PowerBroker2/5_Hole_Probe_PRoject/Calibration_Files/photos/IMG_2492.JPG

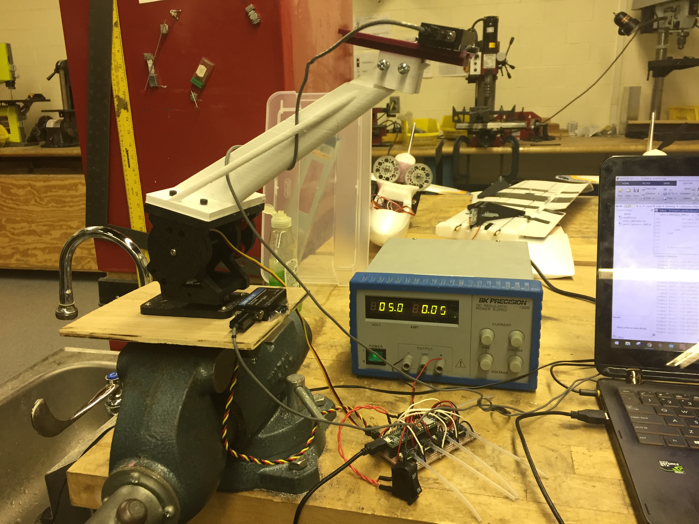
Calibration_Files/photos/IMG_2492.JPG
