PowerBroker2/5_Hole_Probe_PRoject/README.md

# 5 Hole Probe Project
Data acquisition unit for an experimental 5 hole pitot tube.
