PowerBroker2/5_Hole_Probe_PRoject/Teensy_Datalogger_Prototype/pjrc_teensy36_detail.jpg

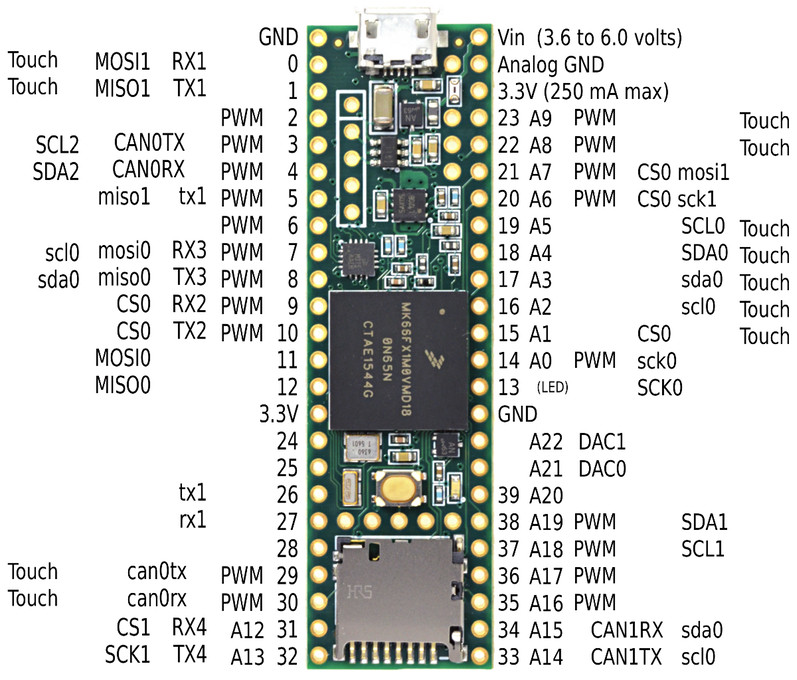
Teensy_Datalogger_Prototype/pjrc_teensy36_detail.jpg
