PowerBroker2/5_Hole_Probe_PRoject/Teensy_Datalogger_Prototype/Pressure_Sensor_Test_Graph.pdf

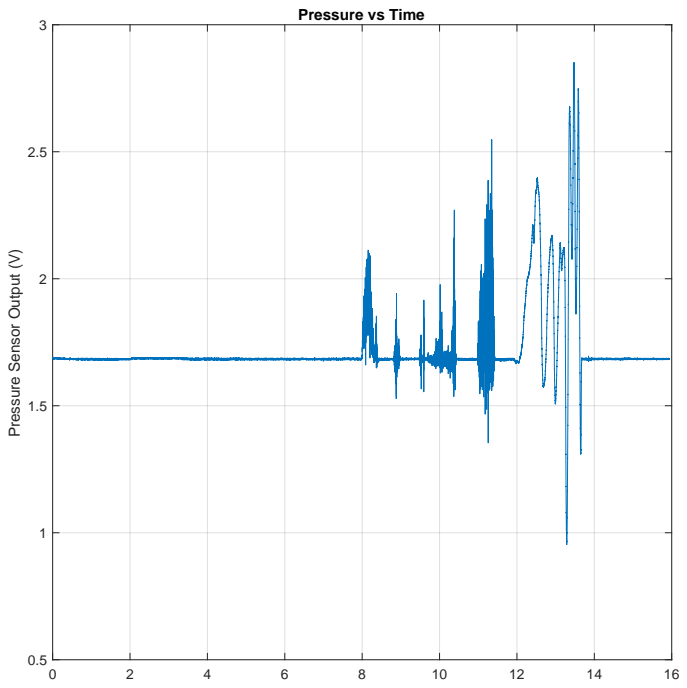
[picture p8: page 1]

Pressure vs Time

Pressure Sensor Output (V)
