PowerBroker2/5_Hole_Probe_PRoject/Teensy_Datalogger_Prototype/Eagle_Schematic/5HP_Datalogger/5HP_Datalogger.sch

## EAGLE design Teensy_Datalogger_Prototype/Eagle_Schematic/5HP_Datalogger/5HP_Datalogger.sch (2019-06-13)

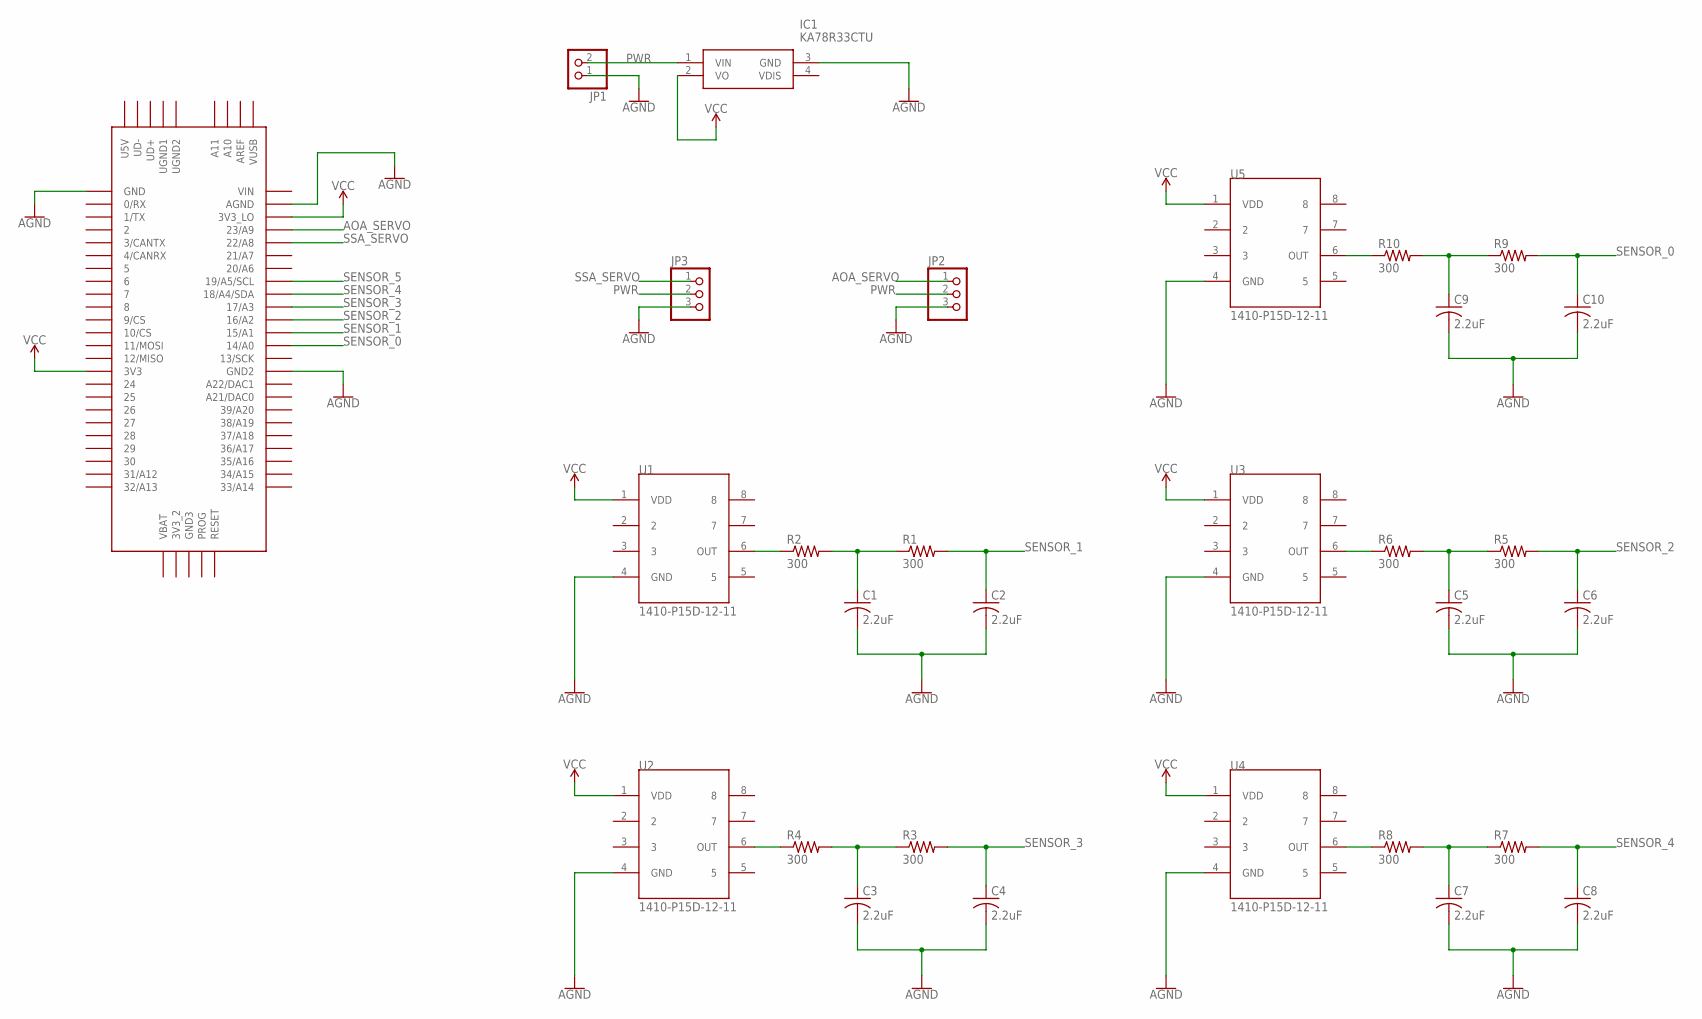
[picture p9: schematic 5HP_Datalogger.sch]

Parts:
C1, C2, C3, C4, C5, C6, C7, C8, C9, C10: 2.2uF; C075-032X103
IC1: KA78R33CTU; TO254P470X1000X1960-4P
JP1: PINHD-1X2; 1X02
JP2, JP3: PINHD-1X3; 1X03
R1, R2, R3, R4, R5, R6, R7, R8, R9, R10: 300; 0207/10
U1, U2, U3, U4, U5: 1410-P15D-12-11
U$2: TEENSY_3.5/3.6

Connections:
AGND: C1.2, C2.2, C3.2, C4.2, C5.2, C6.2, C7.2, C8.2, C9.2, C10.2, IC1.3 (GND), JP1.1, JP2.3, JP3.3, U1.4 (GND), U2.4 (GND), U3.4 (GND), U4.4 (GND), U5.4 (GND), U$2.AGND, U$2.GND, U$2.GND2
AOA_SERVO: JP2.1, U$2.23/A9
unnamed: R2.1, U1.6 (OUT)
unnamed: C1.1, R1.1, R2.2
unnamed: R4.1, U2.6 (OUT)
unnamed: C3.1, R3.1, R4.2
unnamed: R6.1, U3.6 (OUT)
unnamed: C5.1, R5.1, R6.2
unnamed: R8.1, U4.6 (OUT)
unnamed: C7.1, R7.1, R8.2
unnamed: R10.1, U5.6 (OUT)
unnamed: C9.1, R9.1, R10.2
PWR: IC1.1 (VIN), JP1.2, JP2.2, JP3.2
SENSOR_0: C10.1, R9.2, U$2.14/A0
SENSOR_1: C2.1, R1.2, U$2.15/A1
SENSOR_2: C6.1, R5.2, U$2.16/A2
SENSOR_3: C4.1, R3.2, U$2.17/A3
SENSOR_4: C8.1, R7.2, U$2.18/A4/SDA
SENSOR_5: U$2.19/A5/SCL
SSA_SERVO: JP3.1, U$2.22/A8
VCC: IC1.2 (VO), U1.1 (VDD), U2.1 (VDD), U3.1 (VDD), U4.1 (VDD), U5.1 (VDD), U$2.3V3, U$2.3V3_LO
