PowerBroker2/5_Hole_Probe_PRoject/Calibration_Files/before_wind_tunnel_servo_calibration_AOA_15mps.txt

-3.201732
0.748843
0
-3.215551
0.725717
0
-3.228972
0.724204
0
-3.251781
0.724204
0
-3.256113
0.713502
0
-3.248900
0.713502
0
-3.221786
0.721592
0
-3.227844
0.721592
0
-3.251930
0.750256
0
-3.228832
0.750256
0
-3.242966
0.769452
0
-3.221094
0.769452
0
-3.230644
0.737074
0
-3.229918
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
