PowerBroker2/5_Hole_Probe_PRoject/Calibration_Files/before_wind_tunnel_servo_calibration_AOA_5mps.txt

-4.615601
0.366127
0
-4.614052
0.364701
0
-4.617850
0.364701
0
-4.623018
0.367634
0
-4.626394
0.367634
0
-4.624328
0.371338
0
-4.622633
0.371338
0
-4.630738
0.371309
0
-4.631361
0.371309
0
-4.628824
0.373495
0
-4.631854
0.373495
0
-4.639075
0.381193
0
-4.639766
0.381193
0
-4.637459
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
