PowerBroker2/5_Hole_Probe_PRoject/Calibration_Files/servo_calibration_AOA.txt

-3.915763
-0.318949
0
-3.907074
-0.312051
0
-3.907074
-0.308635
0
-3.911110
-0.308825
0
-3.915108
-0.312910
0
-3.915108
-0.299197
0
-3.908336
-0.282846
0
-3.908336
-0.287082
0
-3.909272
-0.279486
0
-3.909272
-0.290173
0
-3.908201
-0.297677
0
-3.908201
-0.302898
0
-3.910052
-0.300701
0
-3.910052
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
