PowerBroker2/5_Hole_Probe_PRoject/Calibration_Files/servo_calibration_SSA.txt

8.269369
0.015792
0
8.266653
0.015966
0
8.266653
0.019892
0
8.272295
0.019791
0
8.272295
0.021852
0
8.279972
0.033060
0
8.279972
0.035749
0
8.285355
0.040184
0
8.285355
0.041495
0
8.284427
0.042166
0
8.284427
0.043680
0
8.288174
0.038051
0
8.288174
0.039533
0
8.296869
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
