PowerBroker2/5_Hole_Probe_PRoject/Calibration_Files/photos/IMG_2491.JPG

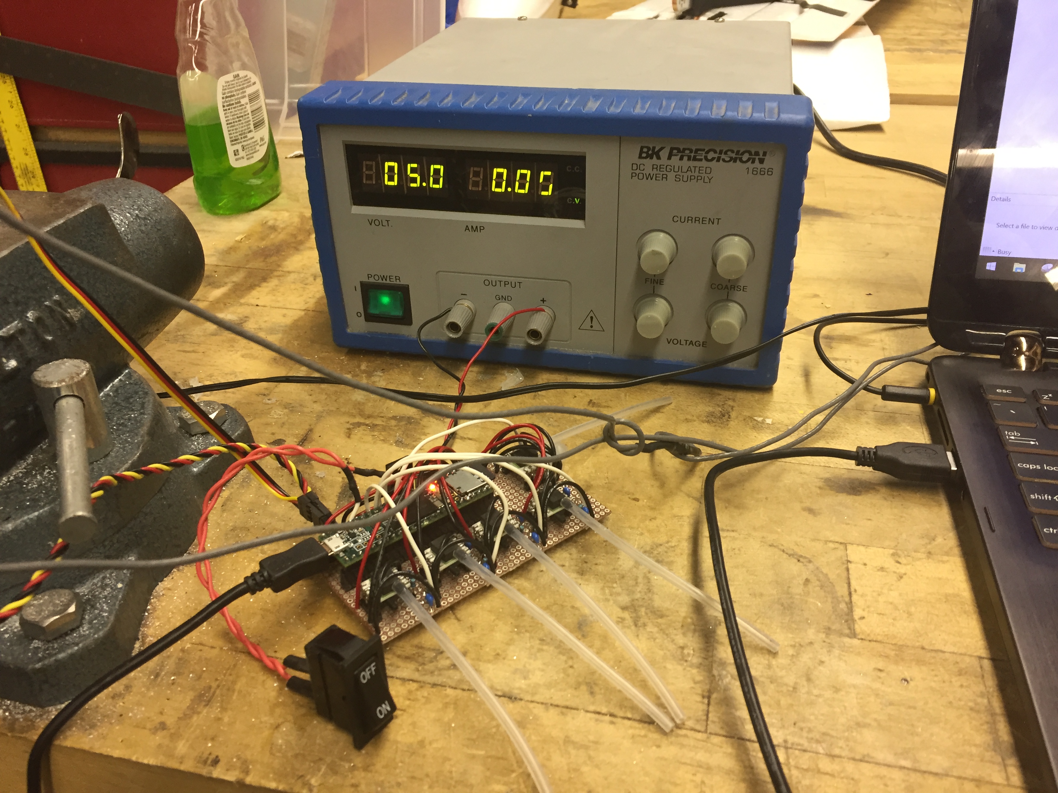
Calibration_Files/photos/IMG_2491.JPG
